tonnerre33/Livolo_EU_2Gang_1way/Pictures/Structure.jpg

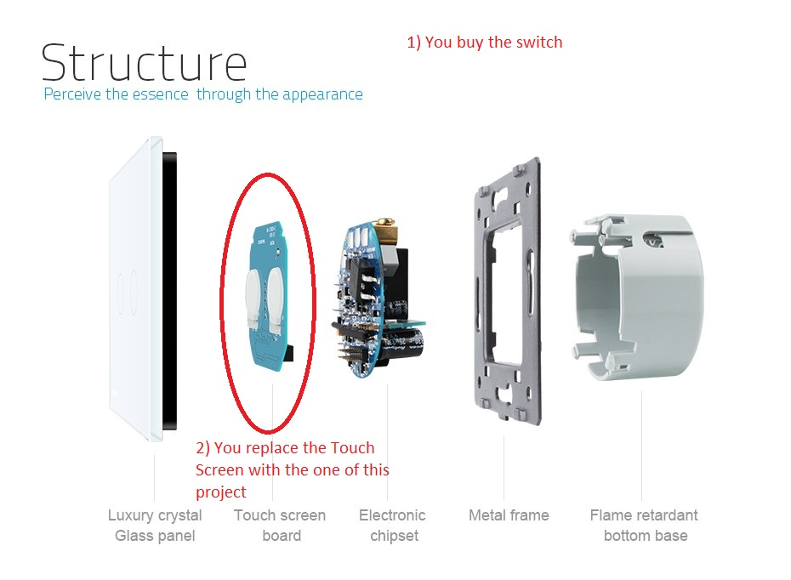
Pictures/Structure.jpg
