tonnerre33/Livolo_EU_2Gang_1way/Livolo_EU_2Gang_1way.pdf

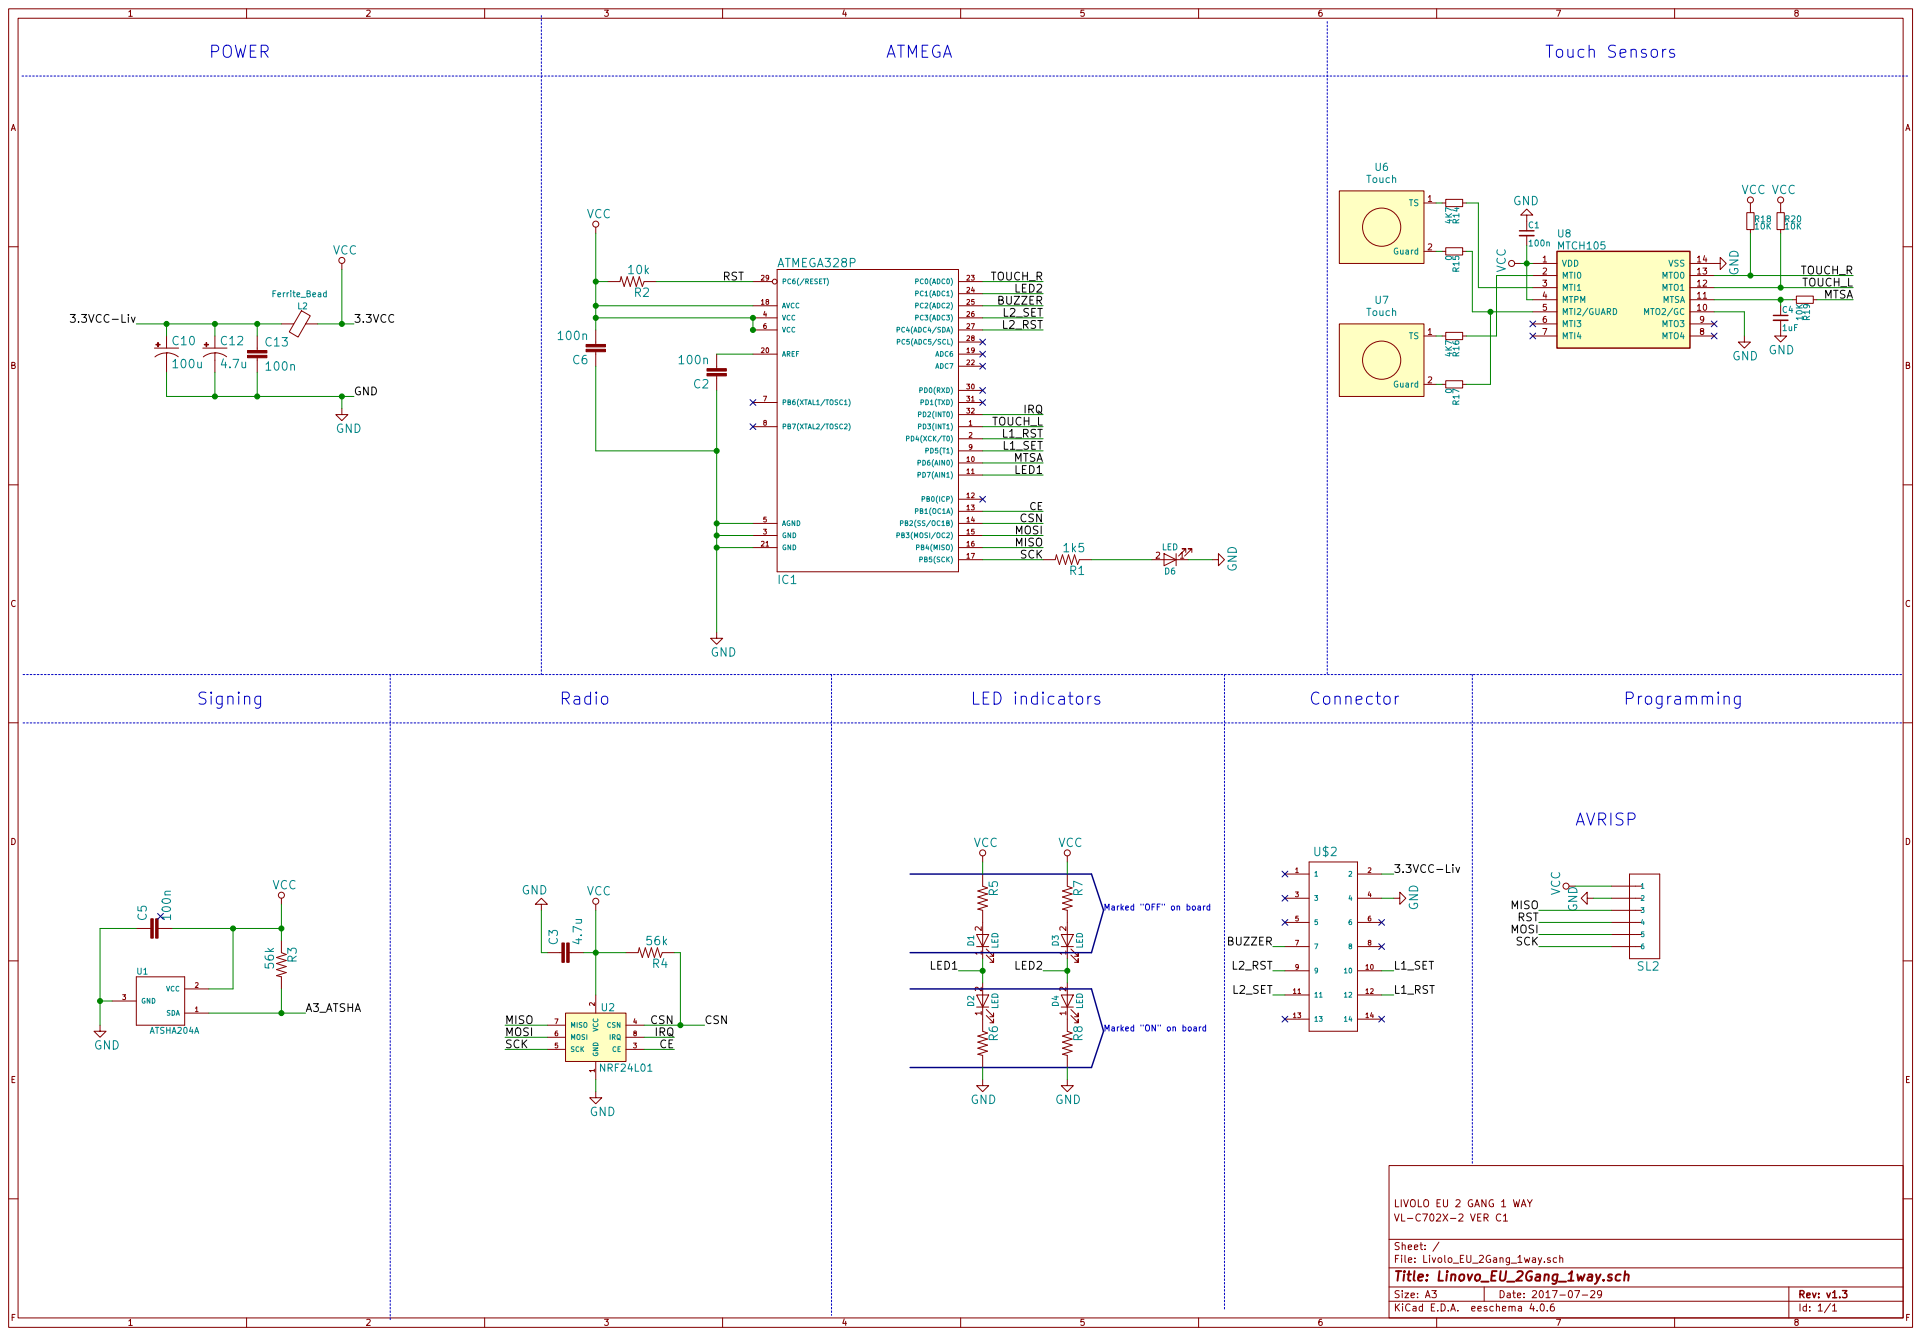
[picture p2: page 1]

L2_SET
L2_RST

TOUCH_L
L1_RST
L1_SET

Marked "OFF" on board Marked "ON" on board

2 CE 3 CSN 4 SCK 5 MOSI 6 MISO 7

File: Livolo_EU_2Gang_1way.sch Sheet: / VL-C702X-2 VER C1
