tonnerre33/Livolo_EU_2Gang_1way/(list of files, drawings)

Other design files:
Livolo_EU_2Gang_1way.dsn
