tonnerre33/Livolo_EU_2Gang_1way/Livolo_EU_2Gang_1way.kicad_pcb

## KiCad design Livolo_EU_2Gang_1way.kicad_pcb (2017-08-26)

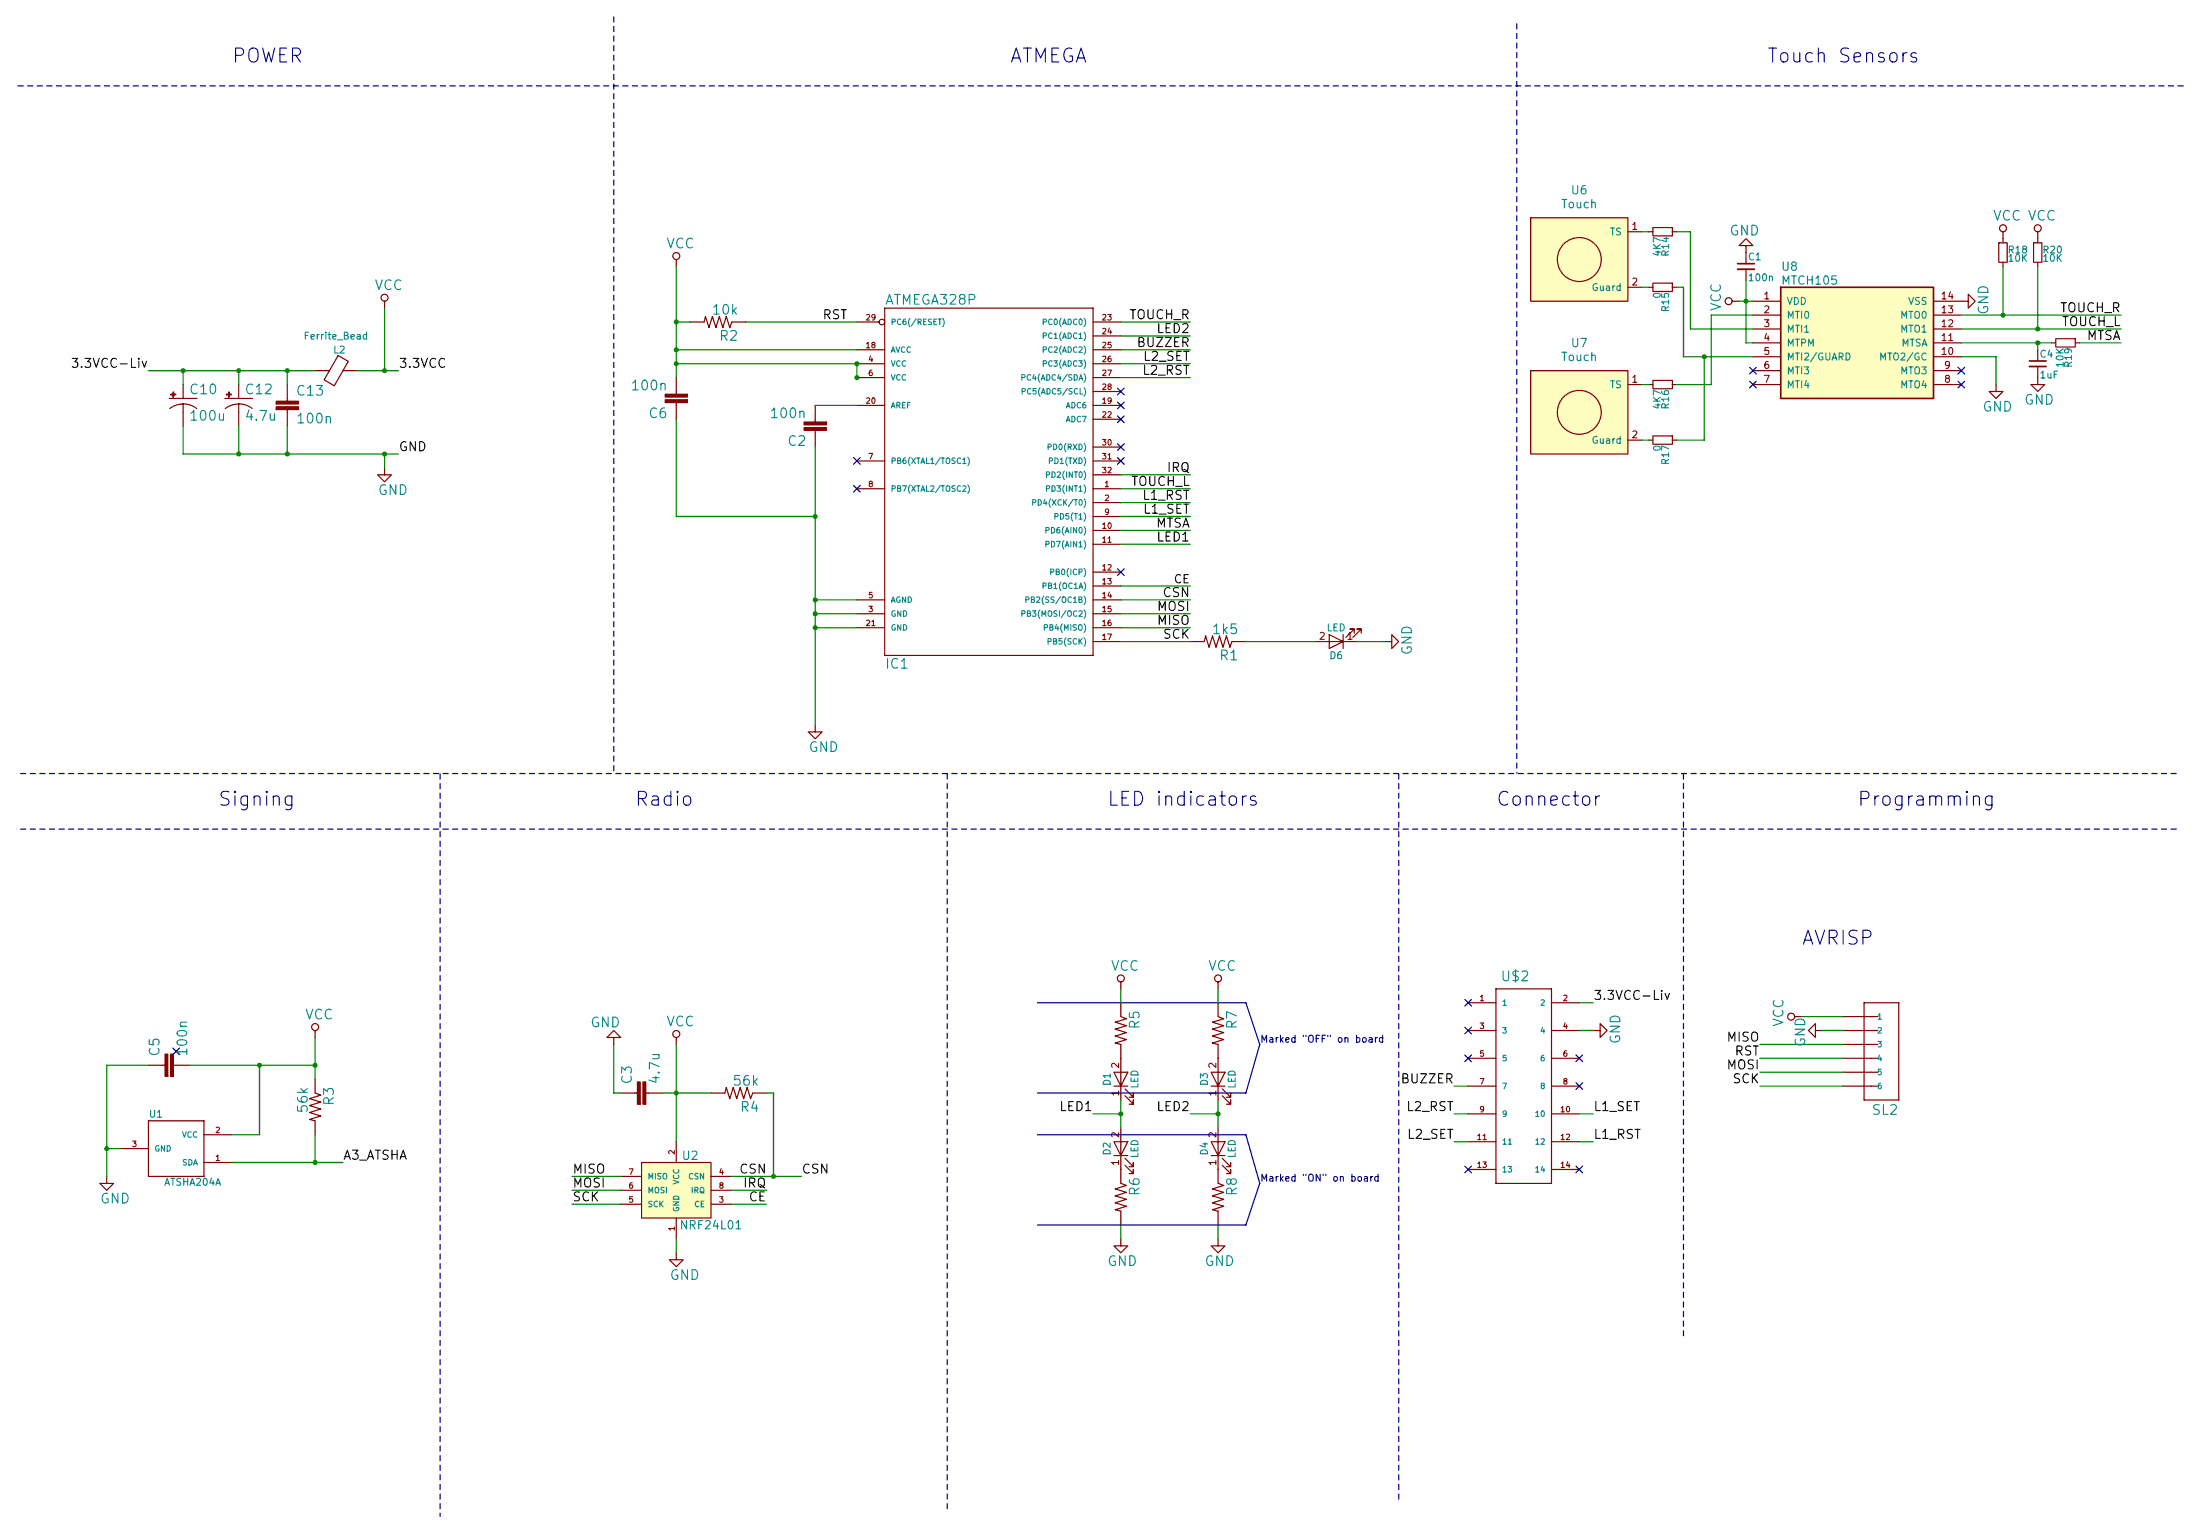
[picture p3: schematic Livolo_EU_2Gang_1way.sch, Linovo_EU_2Gang_1way.sch]

Parts:
C1, C5: 100n; C_0603_HandSoldering
C2, C6: 100n; C_0402
C3: 4.7u; C_0603_HandSoldering
C4: 1uF; C_0603_HandSoldering
C10: 100u; EIA3216; Rating X5R/10V
C12: 4.7u; EIA3216; Rating X5R/10V
C13: 100n; C_0603_HandSoldering; Rating X5R/10V
D1, D2, D3, D4, D6: LED; LED_0603
IC1: ATMEGA328P; TQFP32-08
L2: Ferrite_Bead; R_0603_HandSoldering
R1: 1k5; R_0603_HandSoldering
R2: 10k; R_0603_HandSoldering
R3, R4: 56k; R_0603_HandSoldering
R5, R6, R7, R8: R_0603_HandSoldering
R14, R16: 4K7; R_0603
R15, R17: 0; R_0603
R18, R19, R20: 10K; R_0603
SL2: 1X06-1MM
U1: ATSHA204A; SOT23-3
U2: NRF24L01; NRF24L01-SMD
U6, U7: Touch; livolo_ts_guard
U8: MTCH105; SSOP-14_5.3x6.2mm_Pitch0.65mm
U$2: CONNECTOR_02_X_072MM_SPACING; CONNECTOR_02_X_07_2MM

Connections:
/3.3VCC-Liv: C10.+, C12.+, C13.1, L2.2, U$2.2
/A3_ATSHA: R3.2, U1.1 (SDA)
/BUZZER: IC1.25 (PC2(ADC2)), U$2.7
/CE: IC1.13 (PB1(OC1A)), U2.3 (CE)
/CSN: IC1.14 (PB2(SS/OC1B)), R4.1, U2.4 (CSN)
/IRQ: IC1.32 (PD2(INT0)), U2.8 (IRQ)
/L1_RST: IC1.2 (PD4(XCK/T0)), U$2.12
/L1_SET: IC1.9 (PD5(T1)), U$2.10
/L2_RST: IC1.27 (PC4(ADC4/SDA)), U$2.9
/L2_SET: IC1.26 (PC3(ADC3)), U$2.11
/LED1: D1.1 (K), D2.2 (A), IC1.11 (PD7(AIN1))
/LED2: D3.1 (K), D4.2 (A), IC1.24 (PC1(ADC1))
/MISO: IC1.16 (PB4(MISO)), SL2.3, U2.7 (MISO)
/MOSI: IC1.15 (PB3(MOSI/OC2)), SL2.5, U2.6 (MOSI)
/MTSA: IC1.10 (PD6(AIN0)), R19.1
/RST: IC1.29 (PC6(/RESET)), R2.1, SL2.4
/SCK: IC1.17 (PB5(SCK)), R1.2, SL2.6, U2.5 (SCK)
/TOUCH_L: IC1.1 (PD3(INT1)), R20.2, U8.12 (MTO1)
/TOUCH_R: IC1.23 (PC0(ADC0)), R18.2, U8.13 (MTO0)
GND: C1.1, C2.1, C3.1, C4.2, C5.1, C6.1, C10.-, C12.-, C13.2, D6.1 (K), IC1.3 (GND), IC1.5 (AGND), IC1.21 (GND), R6.2, R8.2, SL2.2, U1.3 (GND), U2.1 (GND), U8.10 (MTO2/GC), U8.14 (VSS), U$2.4
unnamed: C2.2, IC1.20 (AREF)
unnamed: C4.1, R19.2, U8.11 (MTSA)
unnamed: D1.2 (A), R5.2
unnamed: D2.1 (K), R6.1
unnamed: D3.2 (A), R7.2
unnamed: D4.1 (K), R8.1
unnamed: D6.2 (A), R1.1
unnamed: R14.1, U8.3 (MTI1)
unnamed: R14.2, U6.1 (TS)
unnamed: R15.1, R17.1, U8.5 (MTI2/GUARD)
unnamed: R15.2, U6.2 (Guard)
unnamed: R16.1, U8.2 (MTI0)
unnamed: R16.2, U7.1 (TS)
unnamed: R17.2, U7.2 (Guard)
VCC: C1.2, C3.2, C5.2, C6.2, IC1.4 (VCC), IC1.6 (VCC), IC1.18 (AVCC), L2.1, R2.2, R3.1, R4.2, R5.1, R7.1, R18.1, R20.1, SL2.1, U1.2 (VCC), U2.2 (VCC), U8.1 (VDD), U8.4 (MTPM)

Notes on the sheet:
Programming
AVRISP
Touch Sensors
ATMEGA
POWER
Signing
Radio
LED indicators
Marked "OFF" on board
Marked "ON" on board
Connector

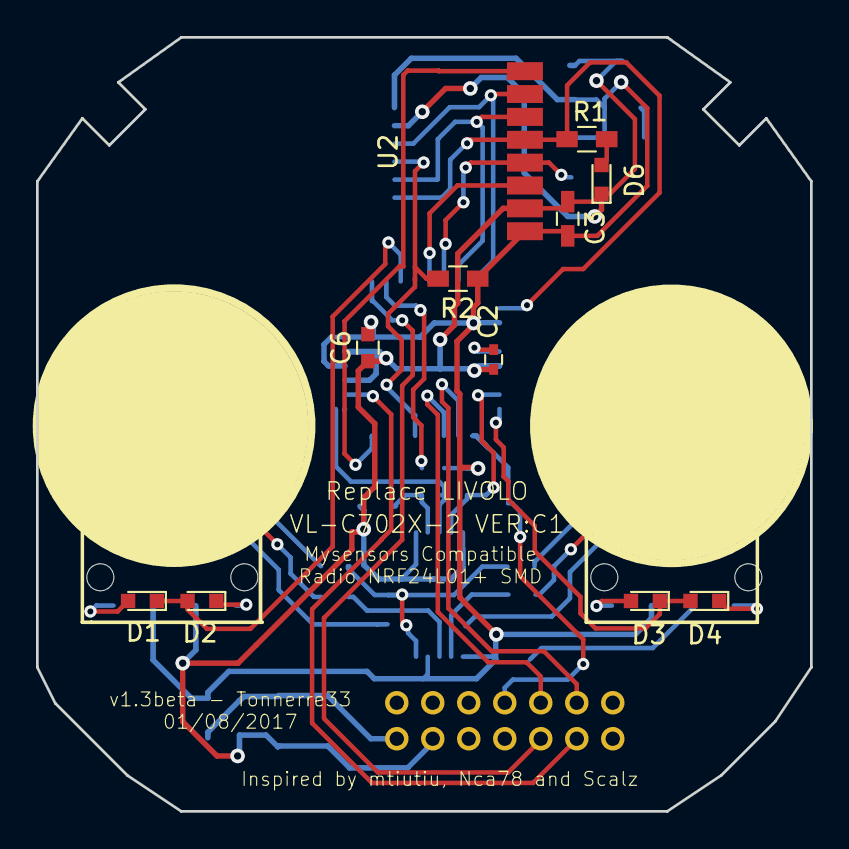
[picture p4: board Livolo_EU_2Gang_1way.kicad_pcb from above]

Board: 2 copper layers, 43.0 x 43.0 mm, 38 parts (0 on the bottom side), 35 nets.
