tonnerre33/Livolo_EU_2Gang_1way/(commit log)

2017-03-26 First version of the PCB
    [EU 2bp.brd, Linovo_EU_2Gang_1way.brd, Linovo_EU_2Gang_1way.sch]
2017-03-26 replace senspad & reroot
    [Linovo_EU_2Gang_1way.brd, Linovo_EU_2Gang_1way.sch]
2017-03-26 Change value RFM69 capacitor
    [Linovo_EU_2Gang_1way.brd, Linovo_EU_2Gang_1way.sch]
2017-04-01 Convert to Kicad
    [EU 2bp.brd, Linovo_EU_2Gang_1way.brd, Linovo_EU_2Gang_1way.kicad_pcb, Linovo_EU_2Gang_1way.sch]
2017-04-01 Correct name project
    [Livolo_EU_2Gang_1way.kicad_pcb, Livolo_EU_2Gang_1way.sch]
2017-04-01 Generate gerber files
    [Livolo_EU_2Gang_1way-B.Mask.gbs, Livolo_EU_2Gang_1way-B.Paste.gbp, Livolo_EU_2Gang_1way-B.SilkS.gbo, Livolo_EU_2Gang_1way-Bottom.gbl, Livolo_EU_2Gang_1way-Edge.Cuts.gm1, Livolo_EU_2Gang_1way-F.Mask.gts, Livolo_EU_2Gang_1way-F.Paste.gtp, Livolo_EU_2Gang_1way-F.SilkS.gto]
2017-04-01 align sens pad
    [Livolo_EU_2Gang_1way.kicad_pcb]
2017-04-01 update gerber
    [Livolo_EU_2Gang_1way-B.Mask.gbs, Livolo_EU_2Gang_1way-B.Paste.gbp, Livolo_EU_2Gang_1way-B.SilkS.gbo, Livolo_EU_2Gang_1way-Bottom.gbl, Livolo_EU_2Gang_1way-Edge.Cuts.gm1, Livolo_EU_2Gang_1way-F.Mask.gts, Livolo_EU_2Gang_1way-F.Paste.gtp, Livolo_EU_2Gang_1way-F.SilkS.gto]
2017-04-01 move capacitor C11
    [Livolo_EU_2Gang_1way-B.Mask.gbs, Livolo_EU_2Gang_1way-B.Paste.gbp, Livolo_EU_2Gang_1way-B.SilkS.gbo, Livolo_EU_2Gang_1way-Bottom.gbl, Livolo_EU_2Gang_1way-Edge.Cuts.gm1, Livolo_EU_2Gang_1way-F.Mask.gts, Livolo_EU_2Gang_1way-F.Paste.gtp, Livolo_EU_2Gang_1way-F.SilkS.gto]
2017-04-01 increase distance between pad and wire
    [Livolo_EU_2Gang_1way.kicad_pcb]
2017-04-01 update gerber files
    [Livolo_EU_2Gang_1way-B.Mask.gbs, Livolo_EU_2Gang_1way-B.Paste.gbp, Livolo_EU_2Gang_1way-B.SilkS.gbo, Livolo_EU_2Gang_1way-Bottom.gbl, Livolo_EU_2Gang_1way-Edge.Cuts.gm1, Livolo_EU_2Gang_1way-F.Mask.gts, Livolo_EU_2Gang_1way-F.Paste.gtp, Livolo_EU_2Gang_1way-F.SilkS.gto]
2017-04-01 saved schema but duno which modif
    [Livolo_EU_2Gang_1way.sch, _saved_Livolo_EU_2Gang_1way.sch]
2017-04-02 move 14 pins connector
    [Livolo_EU_2Gang_1way.kicad_pcb]
2017-04-02 cleanup schema
    [Livolo_EU_2Gang_1way.kicad_pcb, Livolo_EU_2Gang_1way.sch]
2017-04-02 Ceramic capacitor added in parrallel of Tantalum
    [Livolo_EU_2Gang_1way-B.Mask.gbs, Livolo_EU_2Gang_1way-B.Paste.gbp, Livolo_EU_2Gang_1way-B.SilkS.gbo, Livolo_EU_2Gang_1way-Bottom.gbl, Livolo_EU_2Gang_1way-Edge.Cuts.gm1, Livolo_EU_2Gang_1way-F.Mask.gts, Livolo_EU_2Gang_1way-F.Paste.gtp, Livolo_EU_2Gang_1way-F.SilkS.gto]
2017-04-02 optimise position condensator senspad
    [Livolo_EU_2Gang_1way.kicad_pcb]
2017-04-02 correct ERC errors
    [Livolo_EU_2Gang_1way.kicad_pcb]
2017-04-02 optimise position C2
    [Livolo_EU_2Gang_1way-B.Mask.gbs, Livolo_EU_2Gang_1way-B.Paste.gbp, Livolo_EU_2Gang_1way-B.SilkS.gbo, Livolo_EU_2Gang_1way-Bottom.gbl, Livolo_EU_2Gang_1way-Edge.Cuts.gm1, Livolo_EU_2Gang_1way-F.Mask.gts, Livolo_EU_2Gang_1way-F.Paste.gtp, Livolo_EU_2Gang_1way-F.SilkS.gto]
2017-04-02 capacitor added for OTA
    [Livolo_EU_2Gang_1way-B.Mask.gbs, Livolo_EU_2Gang_1way-B.Paste.gbp, Livolo_EU_2Gang_1way-B.SilkS.gbo, Livolo_EU_2Gang_1way-Bottom.gbl, Livolo_EU_2Gang_1way-Edge.Cuts.gm1, Livolo_EU_2Gang_1way-F.Mask.gts, Livolo_EU_2Gang_1way-F.Paste.gtp, Livolo_EU_2Gang_1way-F.SilkS.gto]
2017-04-02 Text cleaning and Readme update
    [Livolo_EU_2Gang_1way-B.Mask.gbs, Livolo_EU_2Gang_1way-B.Paste.gbp, Livolo_EU_2Gang_1way-B.SilkS.gbo, Livolo_EU_2Gang_1way-Bottom.gbl, Livolo_EU_2Gang_1way-Edge.Cuts.gm1, Livolo_EU_2Gang_1way-F.Mask.gts, Livolo_EU_2Gang_1way-F.Paste.gtp, Livolo_EU_2Gang_1way-F.SilkS.gto]
2017-04-08 power node by 12Vcc
    [Livolo_EU_2Gang_1way-B.Mask.gbs, Livolo_EU_2Gang_1way-B.Paste.gbp, Livolo_EU_2Gang_1way-B.SilkS.gbo, Livolo_EU_2Gang_1way-Bottom.gbl, Livolo_EU_2Gang_1way-Edge.Cuts.gm1, Livolo_EU_2Gang_1way-F.Mask.gts, Livolo_EU_2Gang_1way-F.Paste.gtp, Livolo_EU_2Gang_1way-F.SilkS.gto]
2017-04-08 increase clearance netclass POWER from 8 to 10 mil
    [Livolo_EU_2Gang_1way.kicad_pcb]
2017-04-08 replace bad footprint AT25DF512C
    [Livolo_EU_2Gang_1way.kicad_pcb, Livolo_EU_2Gang_1way.sch]
2017-04-08 Replace some capacitor 0402 -> 0603
    [Livolo_EU_2Gang_1way-B.Mask.gbs, Livolo_EU_2Gang_1way-B.Paste.gbp, Livolo_EU_2Gang_1way-B.SilkS.gbo, Livolo_EU_2Gang_1way-Bottom.gbl, Livolo_EU_2Gang_1way-Edge.Cuts.gm1, Livolo_EU_2Gang_1way-F.Mask.gts, Livolo_EU_2Gang_1way-F.Paste.gtp, Livolo_EU_2Gang_1way-F.SilkS.gto]
2017-04-09 add documentation and BOM
    [Livolo_EU_2Gang_1way.csv, Livolo_EU_2Gang_1way.kicad_pcb]
2017-04-15 update gerber files befor order pcb on pcbs.io
    [Livolo_EU_2Gang_1way-B.Mask.gbs, Livolo_EU_2Gang_1way-B.Paste.gbp, Livolo_EU_2Gang_1way-B.SilkS.gbo, Livolo_EU_2Gang_1way-Bottom.gbl, Livolo_EU_2Gang_1way-Edge.Cuts.gm1, Livolo_EU_2Gang_1way-F.Mask.gts, Livolo_EU_2Gang_1way-F.Paste.gtp, Livolo_EU_2Gang_1way-F.SilkS.gto]
2017-04-15 Change FTDI wiring
    [Livolo_EU_2Gang_1way-B.Mask.gbs, Livolo_EU_2Gang_1way-B.Paste.gbp, Livolo_EU_2Gang_1way-B.SilkS.gbo, Livolo_EU_2Gang_1way-Bottom.gbl, Livolo_EU_2Gang_1way-Edge.Cuts.gm1, Livolo_EU_2Gang_1way-F.Mask.gts, Livolo_EU_2Gang_1way-F.Paste.gtp, Livolo_EU_2Gang_1way-F.SilkS.gto]
2017-05-14 add doc
    [Livolo_EU_2Gang_1way.kicad_pcb]
2017-06-13 Change RFM69 by NRF24L01 cause crash
    [Livolo_EU_2Gang_1way.kicad_pcb, Livolo_EU_2Gang_1way.sch]
2017-06-13 Adding Symbols and footprint
2017-06-15 Sketch test
    [Livolo_EU_2Gang_1way.kicad_pcb]
2017-06-16 version NRF24
    [Livolo_EU_2Gang_1way-B.Mask.gbs, Livolo_EU_2Gang_1way-B.Paste.gbp, Livolo_EU_2Gang_1way-B.SilkS.gbo, Livolo_EU_2Gang_1way-Bottom.gbl, Livolo_EU_2Gang_1way-Edge.Cuts.gm1, Livolo_EU_2Gang_1way-F.Mask.gts, Livolo_EU_2Gang_1way-F.Paste.gtp, Livolo_EU_2Gang_1way-F.SilkS.gto]
2017-07-01 update sketch and adding TTP223 documentation
    [Livolo_EU_2Gang_1way-B.Mask.gbs, Livolo_EU_2Gang_1way-B.Paste.gbp, Livolo_EU_2Gang_1way-B.SilkS.gbo, Livolo_EU_2Gang_1way-Bottom.gbl, Livolo_EU_2Gang_1way-Edge.Cuts.gm1, Livolo_EU_2Gang_1way-F.Mask.gts, Livolo_EU_2Gang_1way-F.Paste.gtp, Livolo_EU_2Gang_1way-F.SilkS.gto]
2017-07-29 replace TTP223 by MTCH105
    [Livolo_EU_2Gang_1way.kicad_pcb, Livolo_EU_2Gang_1way.sch]
2017-07-29 ajust silkscreen
    [Livolo_EU_2Gang_1way.kicad_pcb]
2017-07-29 adding shunt for test with or without guard
    [Livolo_EU_2Gang_1way.kicad_pcb, Livolo_EU_2Gang_1way.sch]
2017-07-29 update version to v1.2 + pdf + gerber
    [Livolo_EU_2Gang_1way-B.Mask.gbs, Livolo_EU_2Gang_1way-B.Paste.gbp, Livolo_EU_2Gang_1way-B.SilkS.gbo, Livolo_EU_2Gang_1way-Bottom.gbl, Livolo_EU_2Gang_1way-Edge.Cuts.gm1, Livolo_EU_2Gang_1way-F.Mask.gts, Livolo_EU_2Gang_1way-F.Paste.gtp, Livolo_EU_2Gang_1way-F.SilkS.gto]
2017-07-29 moving C6 for be closer of pin 4 and 5
    [Livolo_EU_2Gang_1way.kicad_pcb]
2017-07-29 moving leds
    [Livolo_EU_2Gang_1way.kicad_pcb]
2017-08-01 changes after mtiutiu advises! thx
    [Livolo_EU_2Gang_1way-B.Mask.gbs, Livolo_EU_2Gang_1way-B.Paste.gbp, Livolo_EU_2Gang_1way-B.SilkS.gbo, Livolo_EU_2Gang_1way-Bottom.gbl, Livolo_EU_2Gang_1way-Edge.Cuts.gm1, Livolo_EU_2Gang_1way-F.Mask.gts, Livolo_EU_2Gang_1way-F.Paste.gtp, Livolo_EU_2Gang_1way-F.SilkS.gto]
2017-08-01 correct pin buzzer
    [Livolo_EU_2Gang_1way-B.Mask.gbs, Livolo_EU_2Gang_1way-B.Paste.gbp, Livolo_EU_2Gang_1way-B.SilkS.gbo, Livolo_EU_2Gang_1way-Bottom.gbl, Livolo_EU_2Gang_1way-Edge.Cuts.gm1, Livolo_EU_2Gang_1way-F.Mask.gts, Livolo_EU_2Gang_1way-F.Paste.gtp, Livolo_EU_2Gang_1way-F.SilkS.gto]
2017-08-05 move sketch directory and correct radio text on pcb
    [Livolo_EU_2Gang_1way.kicad_pcb]
2017-08-25 update sketch for pcb v1.2
2017-08-26 move MTSA pin to a PWM pin of the ATMEGA
    [Livolo_EU_2Gang_1way-B.Mask.gbs, Livolo_EU_2Gang_1way-B.Paste.gbp, Livolo_EU_2Gang_1way-B.SilkS.gbo, Livolo_EU_2Gang_1way-Bottom.gbl, Livolo_EU_2Gang_1way-Edge.Cuts.gm1, Livolo_EU_2Gang_1way-F.Mask.gts, Livolo_EU_2Gang_1way-F.Paste.gtp, Livolo_EU_2Gang_1way-F.SilkS.gto]
2017-08-26 remove resistor for guard
    [Livolo_EU_2Gang_1way-B.Mask.gbs, Livolo_EU_2Gang_1way-B.Paste.gbp, Livolo_EU_2Gang_1way-B.SilkS.gbo, Livolo_EU_2Gang_1way-Bottom.gbl, Livolo_EU_2Gang_1way-Edge.Cuts.gm1, Livolo_EU_2Gang_1way-F.Mask.gts, Livolo_EU_2Gang_1way-F.Paste.gtp, Livolo_EU_2Gang_1way-F.SilkS.gto]
2017-09-16 update sketch for pcb v1.3
